ricknoboa137/OmnidirectionalRobot/STLs/Cover.STL

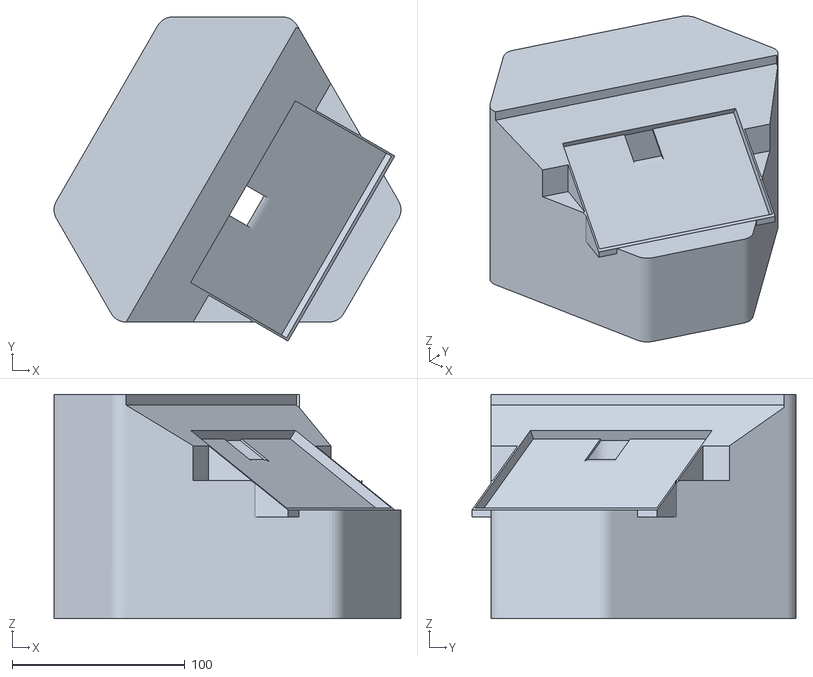
[picture p1: CAD file, 2026-08-31]
STLs/Cover.STL
200.9 x 187.7 x 130.0
