ricknoboa137/OmnidirectionalRobot/STLs/SSDholder.STL

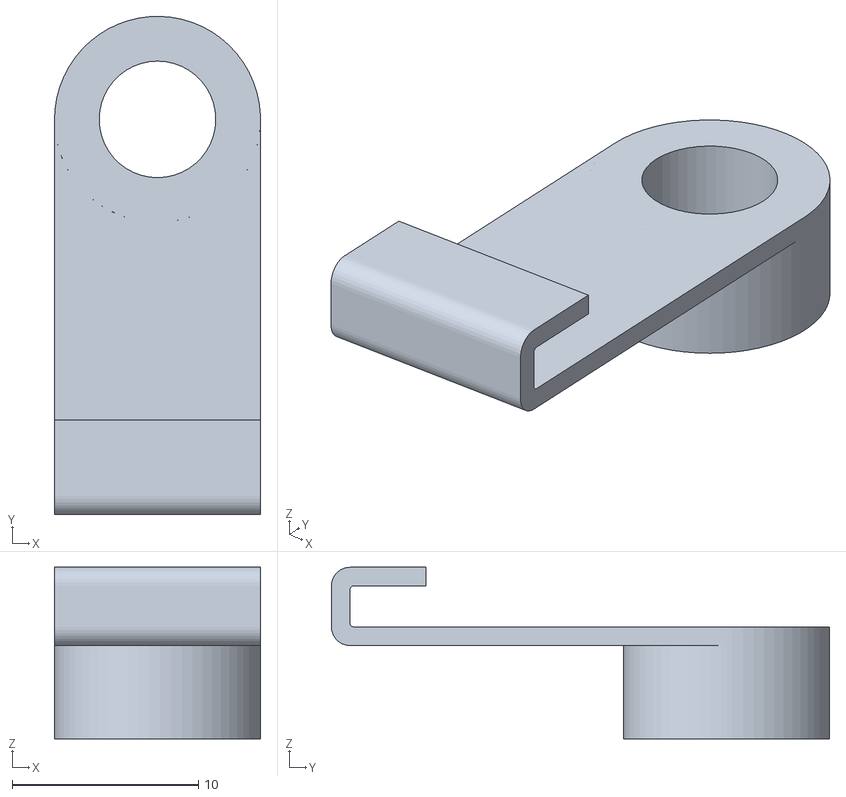
[picture p2: CAD file, 2026-08-31]
STLs/SSDholder.STL
11.1 x 26.7 x 9.20
