ricknoboa137/OmnidirectionalRobot/STLs/MotorCoppler.STL

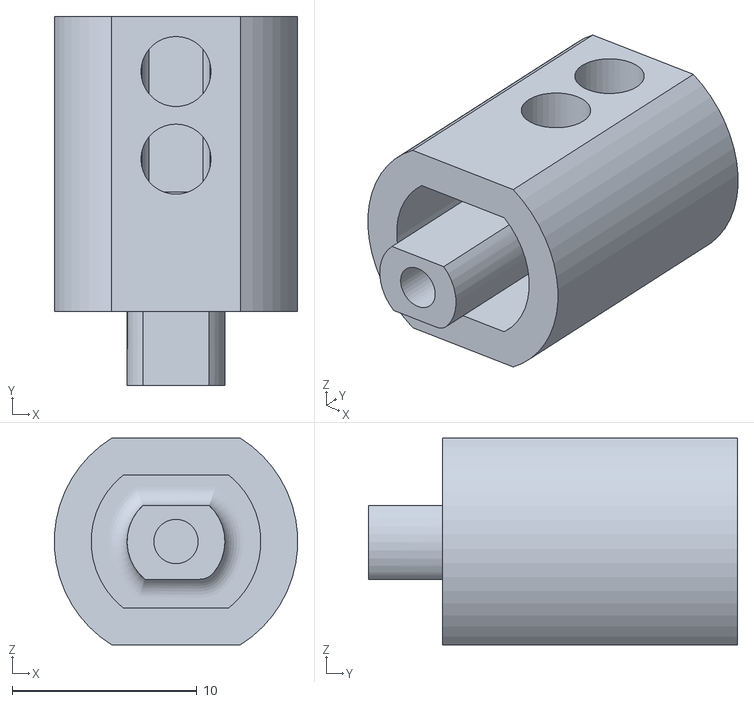
[picture p3: CAD file, 2026-08-31]
STLs/MotorCoppler.STL
13.2 x 20.0 x 11.2
