ricknoboa137/OmnidirectionalRobot/STLs/electronicPlate.STL

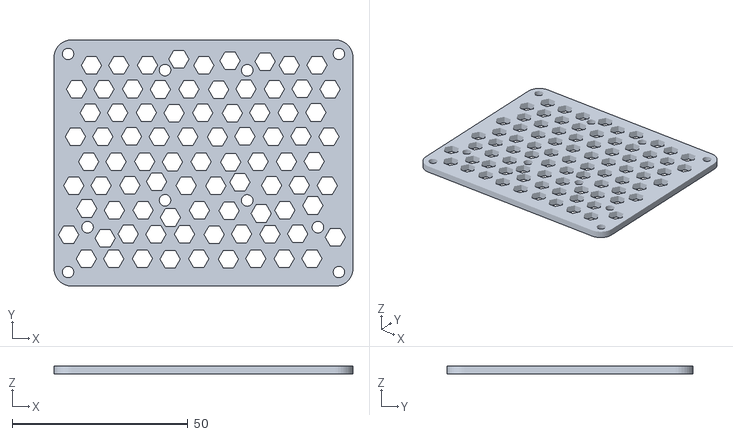
[picture p4: CAD file, 2026-08-31]
STLs/electronicPlate.STL
85.0 x 70.0 x 2.40
