ricknoboa137/OmnidirectionalRobot/STLs/ScreenHolder.STL

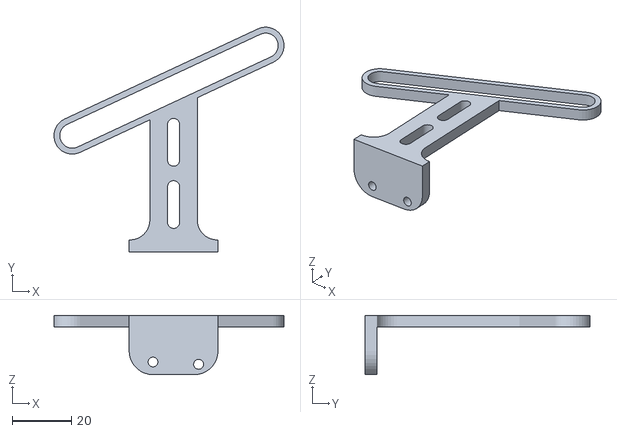
[picture p5: CAD file, 2026-08-31]
STLs/ScreenHolder.STL
77.6 x 75.8 x 20.0
