ricknoboa137/OmnidirectionalRobot/STLs/cliper.STL

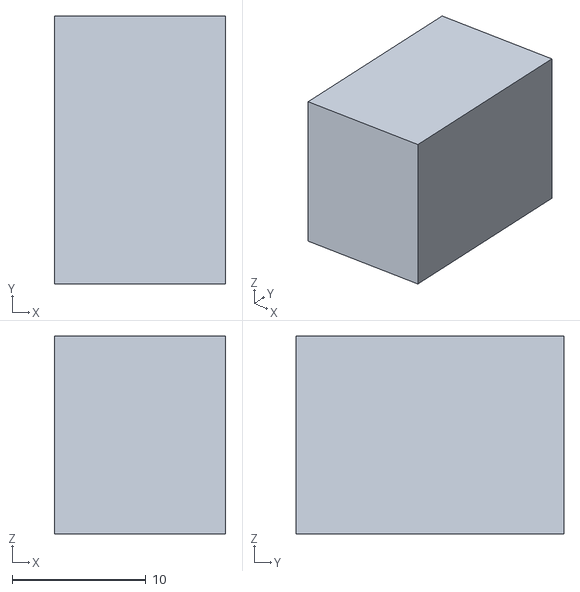
[picture p6: CAD file, 2026-08-31]
STLs/cliper.STL
12.8 x 20.0 x 14.8
