ricknoboa137/OmnidirectionalRobot/STLs/spacer.STL

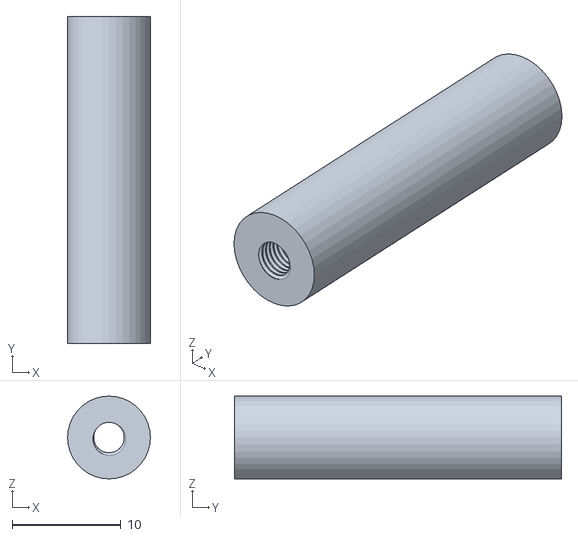
[picture p7: CAD file, 2026-08-31]
STLs/spacer.STL
7.60 x 30.0 x 7.60
