ricknoboa137/OmnidirectionalRobot/STLs/CoupperOmniWheel2.STL

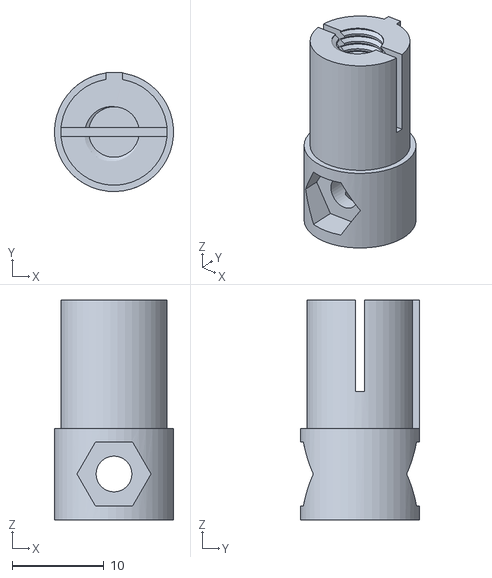
[picture p8: CAD file, 2026-08-31]
STLs/CoupperOmniWheel2.STL
13.0 x 13.0 x 24.0
