ricknoboa137/OmnidirectionalRobot/STLs/BatteryHolder.STL

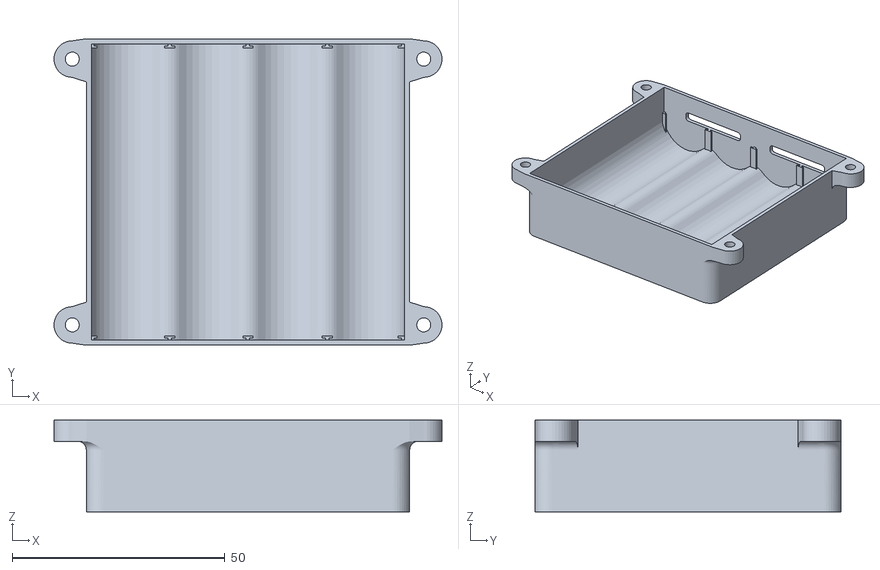
[picture p9: CAD file, 2026-08-31]
STLs/BatteryHolder.STL
91.2 x 72.0 x 21.6
