ricknoboa137/OmnidirectionalRobot/STLs/Chasis.STL

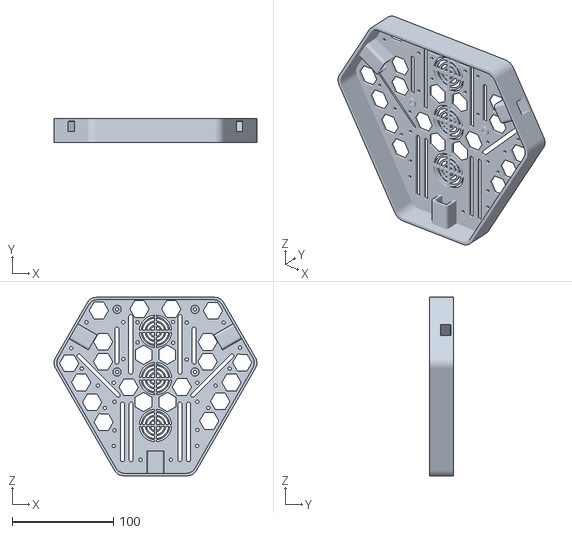
[picture p10: CAD file, 2026-08-31]
STLs/Chasis.STL
200.9 x 23.4 x 176.7
