ricknoboa137/OmnidirectionalRobot/(commit log)

2024-08-06 Update ESP32_MotorDriver.ino
    Added led-status function
2024-09-27 Update ESP32_MotorDriver.ino
    motor driver updated
2026-08-27 Keep a backup copy of the original motor driver firmware
    Copy of ESP32_MotorDriver.ino as it was before the telemetry section was
    added, in its own folder so it still builds as a standalone sketch.
2026-08-27 Add wheel velocity telemetry and host-side logger
    Firmware:
    - publish one CSV row per control cycle (seq, time, setpoint, measured
    velocity and signed PWM for each wheel) on the motor_telemetry topic
    - batch 8 rows per MQTT message and enlarge the PubSubClient buffer, so
    the 200 Hz sample rate is kept without flooding the broker
    - drop batches instead of blocking the control loop when MQTT is down
    - start/stop the stream, or mirror it on the serial port, through the
    motor_telemetry_ctrl topic
    - bound the payload copy in the MQTT callback
    Host:
    - velocity_logger.py records the stream to a CSV log file, reports the
    sample rate, counts lost rows and plots setpoint vs. measured velocity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
    [ESP32_MotorDriver.ino]
2026-08-27 Fix the delay between a velocity command and the wheels moving
    - disable WiFi modem sleep: the ESP32 station defaults to WIFI_PS_MIN_MODEM,
    so incoming MQTT setpoints waited for the next AP beacon before being
    delivered, adding a few hundred ms of variable latency
    - set the PID sample time to the 5 ms the velocities are sampled at; the
    library defaults to 100 ms, so Compute() discarded 19 of every 20 calls
    - raise the lower output limit to the PWM where the wheels actually start
    turning, so the integral term no longer has to ramp up through the motor
    dead zone after every stop
    - scale the measured velocity into the units of the setpoints, with a single
    constant to switch between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
    [velocities_20260827_134629.csv, velocities_20260827_134715.csv, velocities_20260827_140124.csv]
2026-08-27 Split the driver into a control task and a network task
    The single loop mixed the control with the networking, so an MQTT publish,
    a broker timeout or a reconnection stalled the wheels and the setpoints were
    acted on late.
    - ControlTask, core 1, priority 3: encoders, velocity filter, PID and PWM on a
    fixed 5 ms period through vTaskDelayUntil. It never touches the network - it
    reads the setpoints from a spinlock protected variable and pushes the
    measurements into a queue.
    - NetworkTask, core 0: WiFi, MQTT, telemetry publishing and the status LED.
    Everything here is allowed to be slow.
    - reconnect() no longer blocks or restarts the board: one attempt every 2 s
    while the wheels keep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
    [velocities_20260827_142458.csv]
2026-08-27 Point the driver at the same broker as the backup sketch and the logger
    [ESP32_MotorDriver.ino]
2026-08-27 Go back to the single loop driver
    Reverts the FreeRTOS split and the cm/s change: the previous version is the
    one running on the robot and it behaves well. The two task version stays in
    the history if it is ever needed.
    [ESP32_MotorDriver.ino]
2026-08-27 Plot the logs the way the original serial plot did
    - the PID output shares the velocity axis, normalised as normValue*255/10,
    which is the raw PWM divided by 10
    - the x axis is the sample count from the seq column instead of seconds
    - traces named and coloured as before: VelX blue, SP_X red, Cntrl_X green
    - --first and --count window the log on a single step response
2026-08-30 Draw the samples as a zero order hold
    Each logged value is held until the next sample is taken, so joining the
    samples with straight lines shows intermediate values that were never
    measured or commanded. --lines restores the old straight line drawing.
2026-08-30 Restore the original controller for repeating the experiment
    The control law is back to the original one so the run can be compared with
    the published figure: the PID keeps the library default 100 ms sample time
    and the default 0-255 output limits, and the velocity is computed over the
    nominal sampleTime window. The sample time fix, the PWM floor, the measured
    sampling window and the unit scaling are all removed.
    Only the telemetry is kept, so the run can be logged and plotted, together
    with WiFi.setSleep(false), which changes when a command is delivered but not
    how the wheel responds to it. That line is marked in setup() and can be
    commented out to run exactly the original firmware.
    [ESP32_MotorDriver.ino]
2026-08-30 Point the driver and the logger at the current broker
    The setpoint publisher in practice1.ipynb now uses 10.8.9.178, while the
    driver was still compiled with 192.168.0.109 and the logger defaulted to
    192.168.0.153, so nothing would have met on the same broker.
    [ESP32_MotorDriver.ino]
2026-08-31 Added STL files to 3D print parts
    [BatteryHolder.STL, Chasis.STL, CoupperOmniWheel2.STL, Cover.STL, MotorCoppler.STL, SSDholder.STL, ScreenHolder.STL, cliper.STL]
